fourstix/PicoElfPixieVideoGLCDV2/docs/PicoElfPixieVideoGLCDV2.pdf

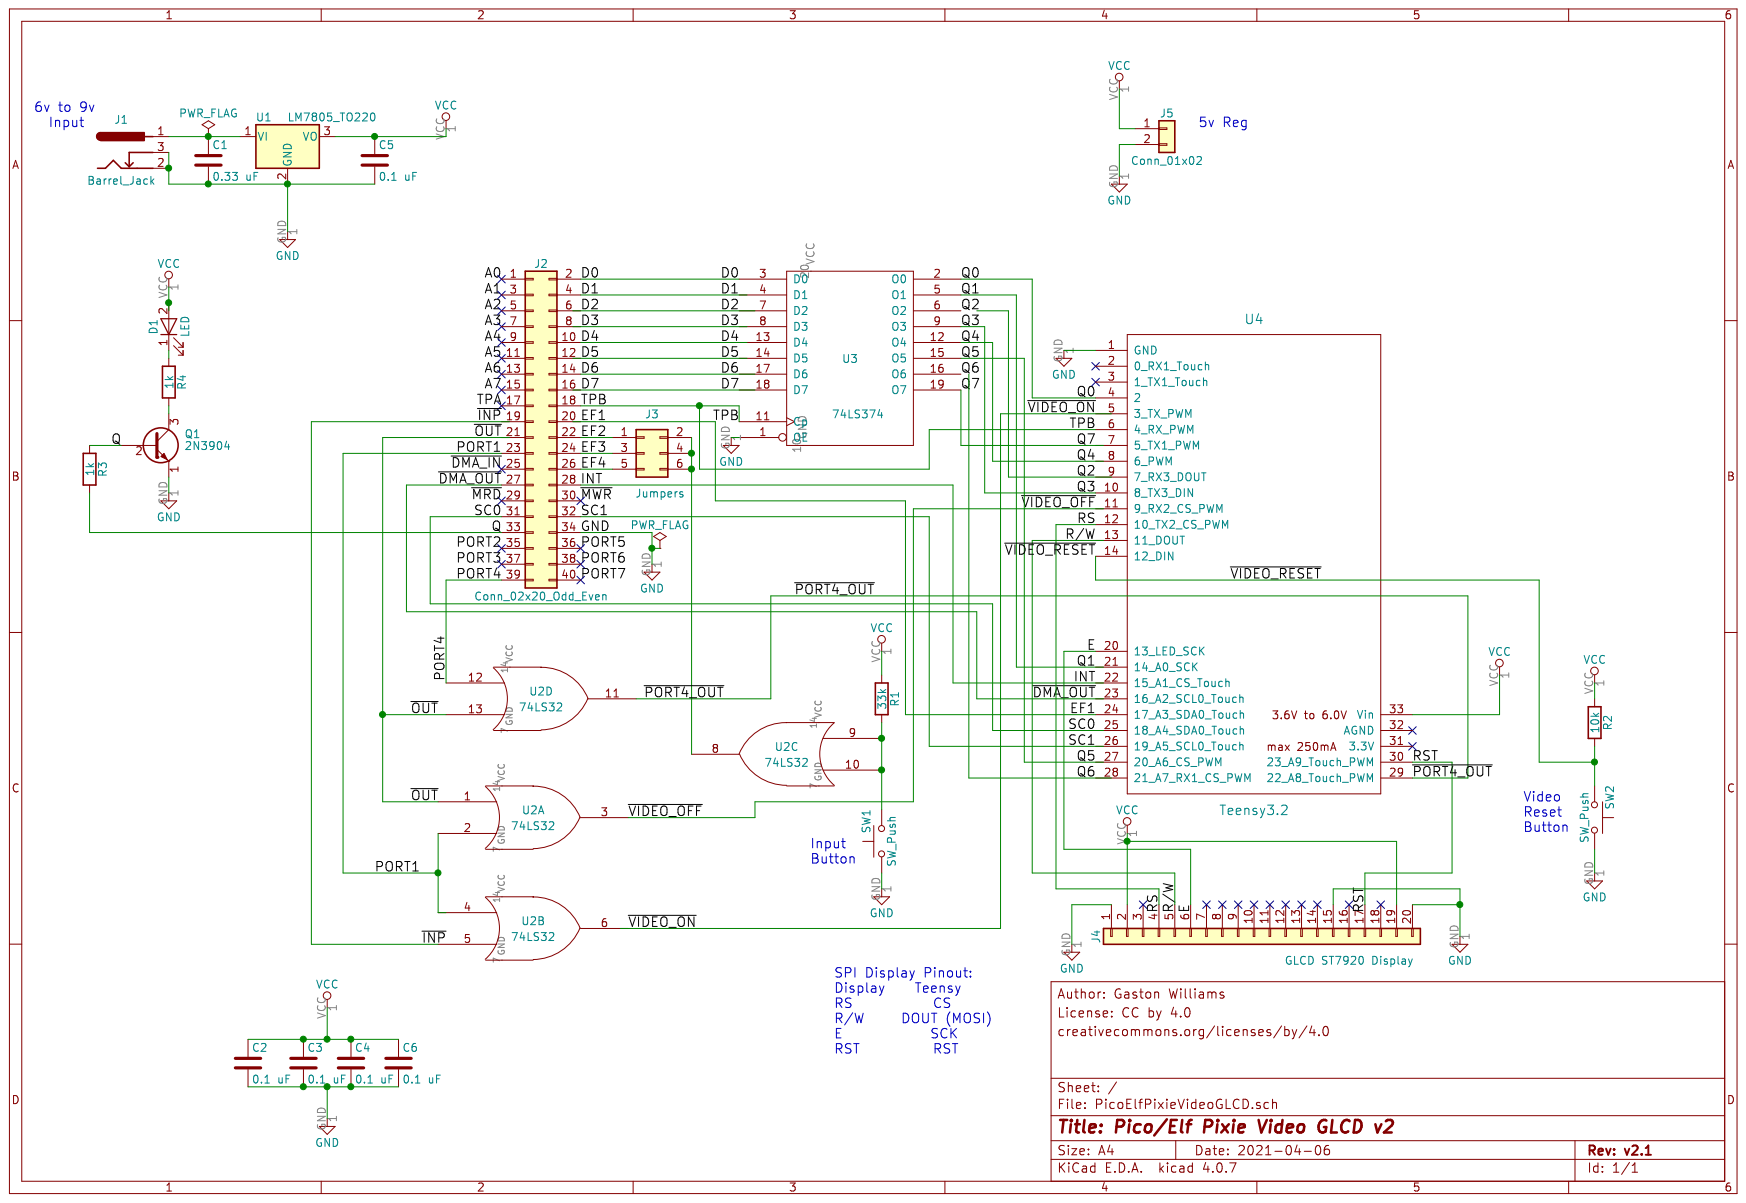
[picture p7: page 1]
