fourstix/PicoElfPixieVideoGLCDV2/(threads)

Thread 1 (2021-09-16):

Remove Sprinkles from display updates

fourstix, 2021-09-16:
Fix a random issue where occasionally invalid data flashes on screen due to the DMA timing mismatch

fourstix, 2021-09-16:
Simplified logic for DMA Ack check at end of line and removed unused variable.

Closed 2021-09-16.
