fourstix/PicoElfPixieVideoGLCDV2/(commit log)

2021-04-23 Changed name of KiCad archive file
2021-04-23 Add outline for BOM table
2021-04-24 Updated readme with BOM
2021-09-16 Fixed timing issue in DMA logic
    [PicoElfPixieVideoGLCDV2.ino]
